WhiteFossa/ProjectFIH/README.md

# ProjectFIH
Digitally-controlled thermostat for heating outdoor hardware
