WhiteFossa/ProjectFIH/Hardware/Ideas/Idea 1.jpg

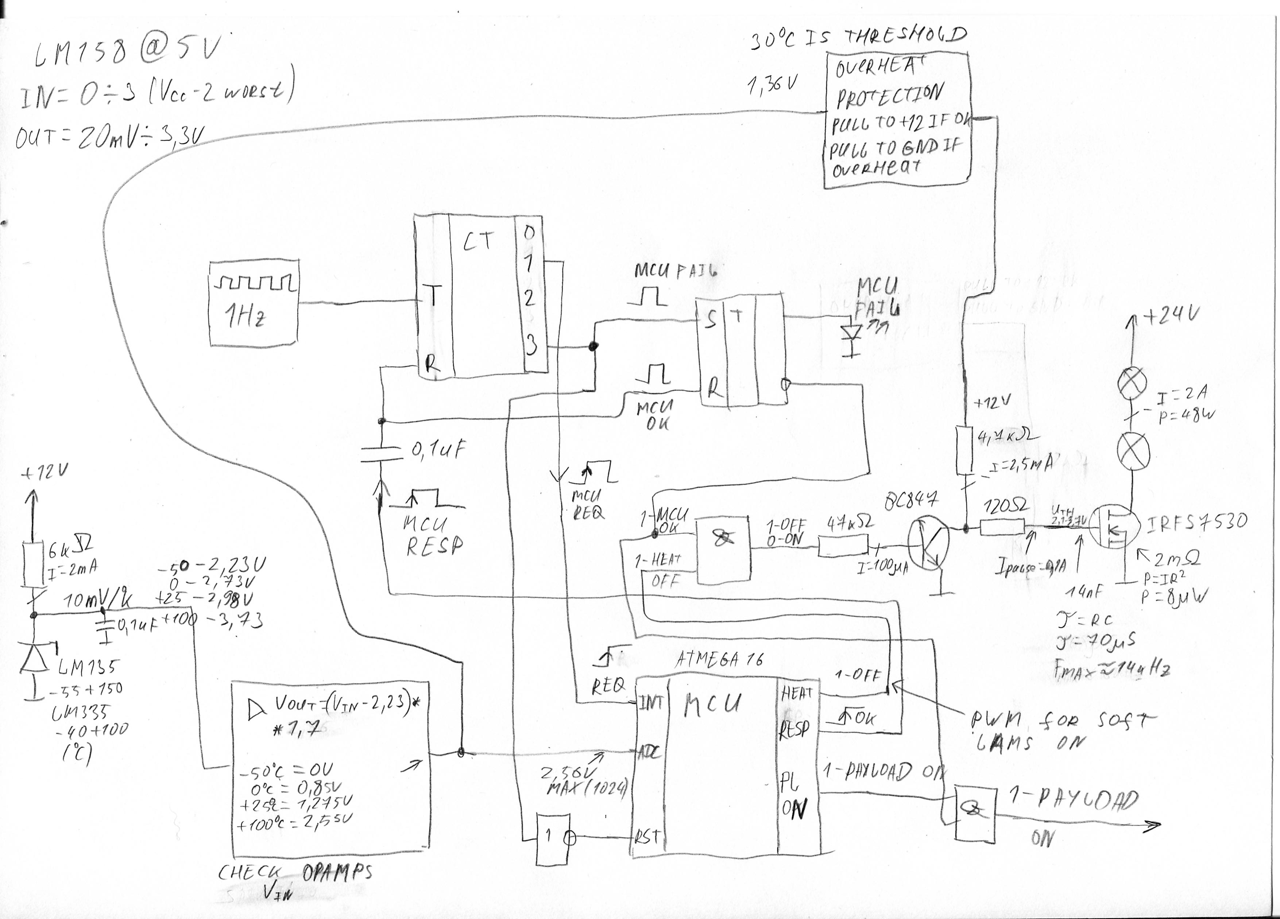
Hardware/Ideas/Idea 1.jpg
