WhiteFossa/ProjectFIH/Hardware/Ideas/Idea 2.jpg

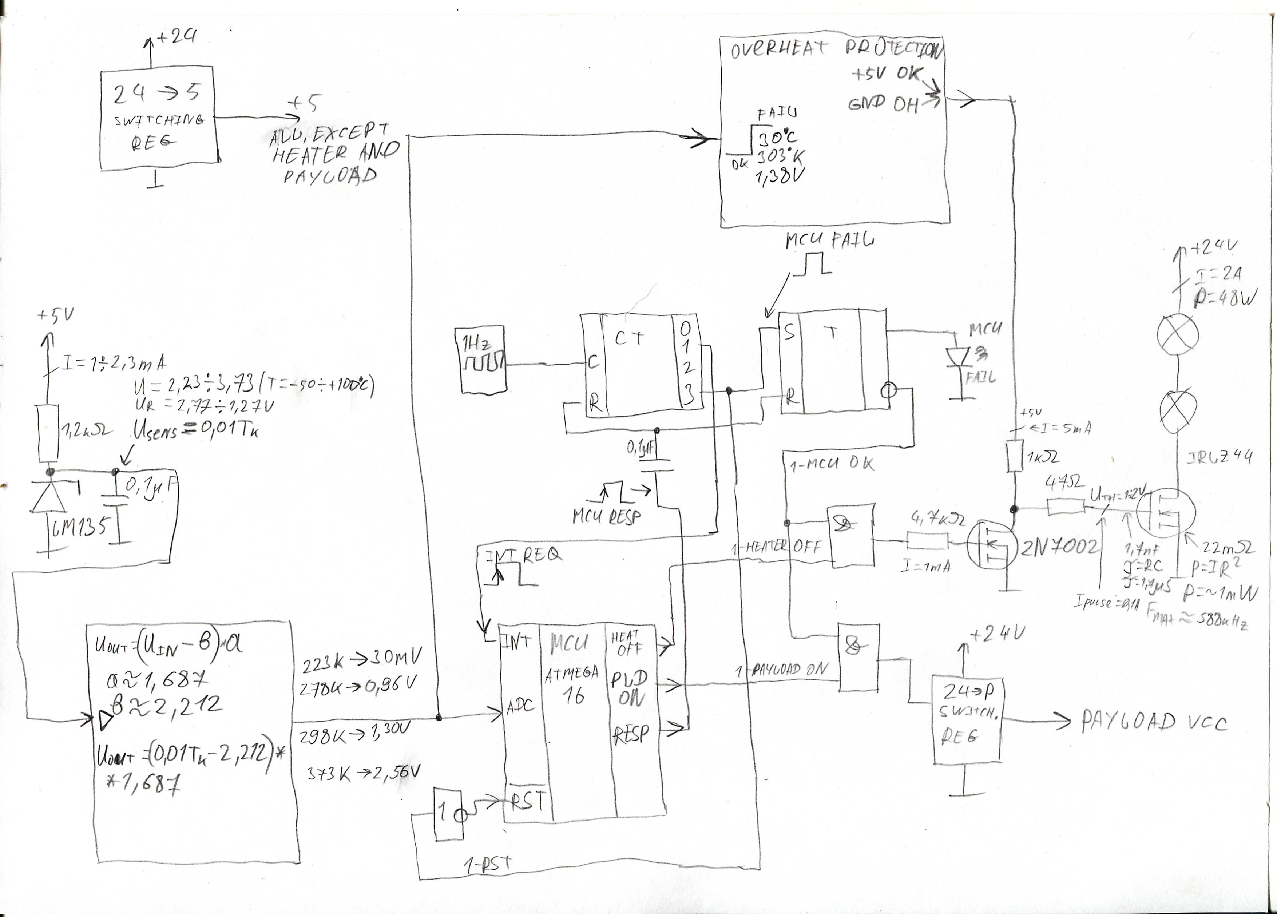
Hardware/Ideas/Idea 2.jpg
