WhiteFossa/ProjectFIH/Hardware/Complete/ProjectFIH/ProjectFIH.kicad_pcb

## KiCad design Hardware/Complete/ProjectFIH/ProjectFIH.kicad_pcb (2020-09-09)

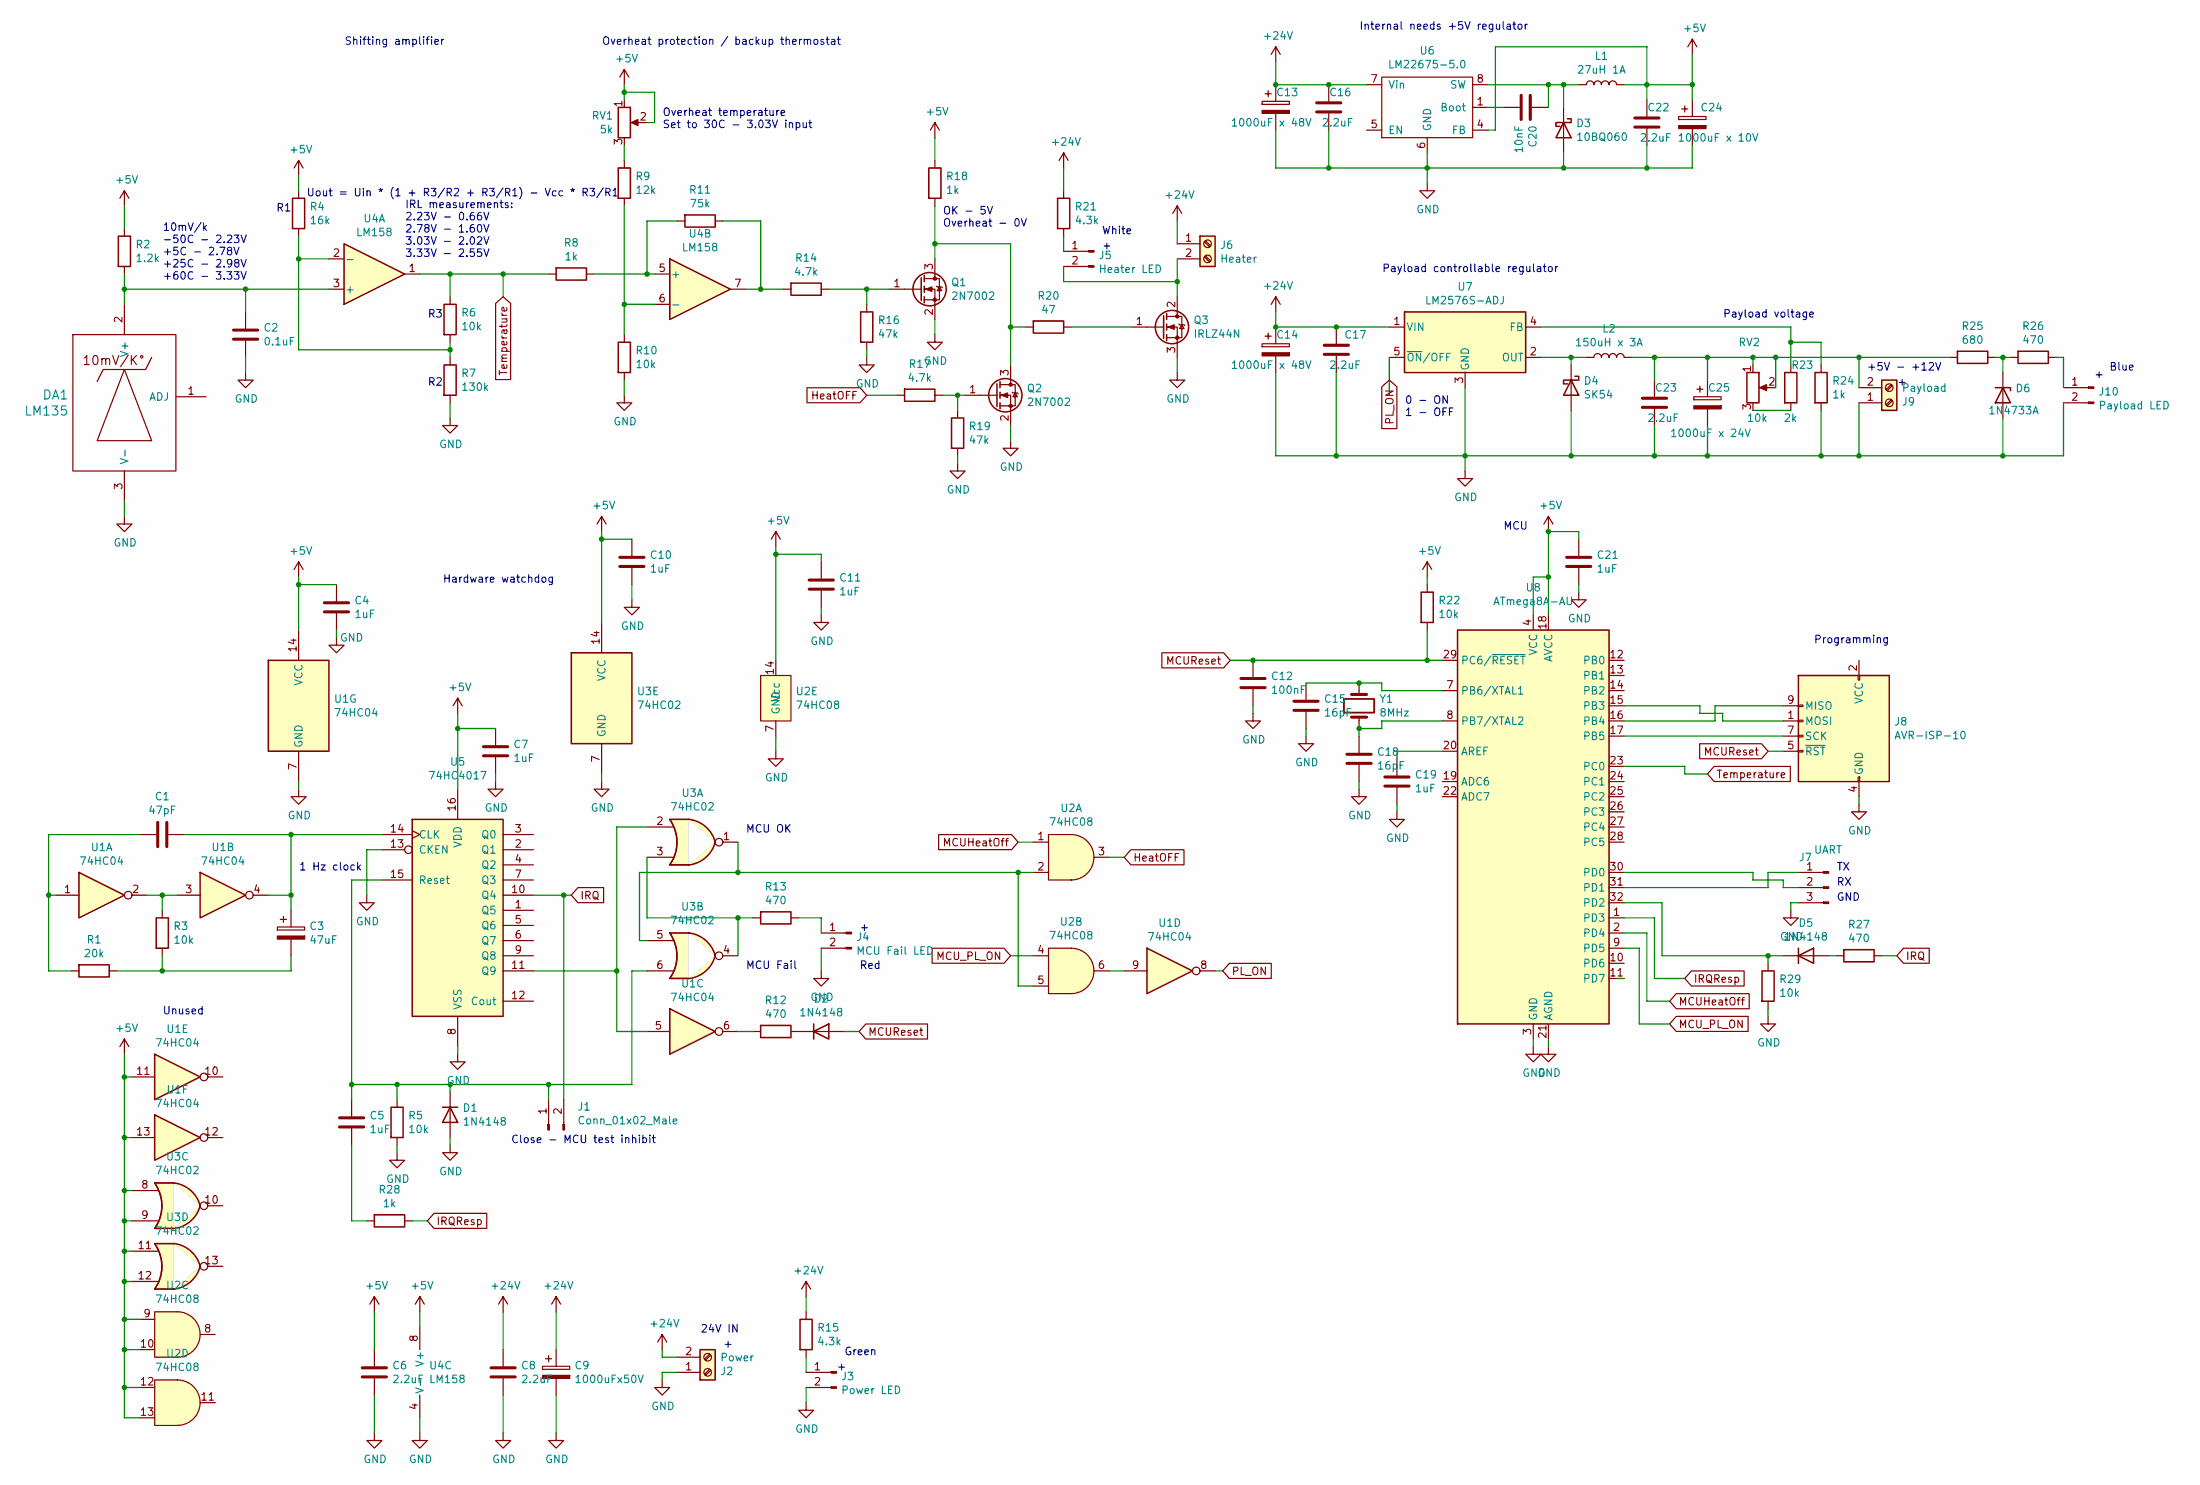
[picture p3: schematic ProjectFIH.sch, Project FIH]

Parts:
C1: 47pF; C_0805_2012Metric_Pad1.15x1.40mm_HandSolder
C2: 0.1uF; C_0805_2012Metric_Pad1.15x1.40mm_HandSolder
C3: 47uF; CP_Elec_4x5.7
C4, C5, C7, C10, C11, C19, C21: 1uF; C_0805_2012Metric_Pad1.15x1.40mm_HandSolder
C6, C8, C16, C17, C22, C23: 2.2uF; C_0805_2012Metric_Pad1.15x1.40mm_HandSolder
C9: 1000uFx50V; CP_Radial_D12.5mm_P5.00mm
C12: 100nF; C_0805_2012Metric_Pad1.15x1.40mm_HandSolder
C13, C14: 1000uF x 48V; CP_Radial_D12.5mm_P5.00mm
C15, C18: 16pF; C_0805_2012Metric_Pad1.15x1.40mm_HandSolder
C20: 10nF; C_0805_2012Metric_Pad1.15x1.40mm_HandSolder
C24: 1000uF x 10V; CP_Radial_D10.0mm_P5.00mm
C25: 1000uF x 24V; CP_Radial_D10.0mm_P5.00mm
D1, D2, D5: 1N4148; D_1210_3225Metric
D3: 10BQ060; D_SMB
D4: SK54; D_SMC
D6: 1N4733A; D_1210_3225Metric
DA1: LM135; TO-92
J1: Conn_01x02_Male; PinHeader_1x02_P2.54mm_Vertical
J2: Power; TerminalBlock_Altech_AK300-2_P5.00mm
J3: Power LED; PinHeader_1x02_P2.54mm_Vertical
J4: MCU Fail LED; PinHeader_1x02_P2.54mm_Vertical
J5: Heater LED; PinHeader_1x02_P2.54mm_Vertical
J6: Heater; TerminalBlock_Altech_AK300-2_P5.00mm
J7: UART; PinHeader_1x03_P2.54mm_Vertical
J8: AVR-ISP-10; IDC-Header_2x05_P2.54mm_Vertical
J9: Payload; TerminalBlock_Altech_AK300-2_P5.00mm
J10: Payload LED; PinHeader_1x02_P2.54mm_Vertical
L1: 27uH 1A; L_Radial_D10.0mm_P5.00mm_Fastron_07M
L2: 150uH x 3A; L_Radial_D16.8mm_P11.43mm_Vishay_IHB-1
Q1, Q2: 2N7002; SOT-23
Q3: IRLZ44N; TO-220-3_Horizontal_TabDown
R1: 20k; R_0805_2012Metric_Pad1.15x1.40mm_HandSolder
R2: 1.2k; R_0805_2012Metric_Pad1.15x1.40mm_HandSolder
R3, R5, R6, R10, R22, R29: 10k; R_0805_2012Metric_Pad1.15x1.40mm_HandSolder
R4: 16k; R_0805_2012Metric_Pad1.15x1.40mm_HandSolder
R7: 130k; R_0805_2012Metric_Pad1.15x1.40mm_HandSolder
R8, R18, R24, R28: 1k; R_0805_2012Metric_Pad1.15x1.40mm_HandSolder
R9: 12k; R_0805_2012Metric_Pad1.15x1.40mm_HandSolder
R11: 75k; R_0805_2012Metric_Pad1.15x1.40mm_HandSolder
R12, R13, R26, R27: 470; R_0805_2012Metric_Pad1.15x1.40mm_HandSolder
R14, R17: 4.7k; R_0805_2012Metric_Pad1.15x1.40mm_HandSolder
R15, R21: 4.3k; R_0805_2012Metric_Pad1.15x1.40mm_HandSolder
R16, R19: 47k; R_0805_2012Metric_Pad1.15x1.40mm_HandSolder
R20: 47; R_0805_2012Metric_Pad1.15x1.40mm_HandSolder
R23: 2k; R_0805_2012Metric_Pad1.15x1.40mm_HandSolder
R25: 680; R_0805_2012Metric_Pad1.15x1.40mm_HandSolder
RV1: 5k; Potentiometer_Bourns_3296W_Vertical
RV2: 10k; Potentiometer_Bourns_3296W_Vertical
U1: 74HC04; SOIC-14_3.9x8.7mm_P1.27mm
U2: 74HC08; SOIC-14_3.9x8.7mm_P1.27mm
U3: 74HC02; SOIC-14_3.9x8.7mm_P1.27mm
U4: LM158; SOIJ-8_5.3x5.3mm_P1.27mm
U5: 74HC4017; SOIC-16_4.55x10.3mm_P1.27mm
U6: LM22675-5.0; SOIC-8_3.9x4.9mm_P1.27mm
U7: LM2576S-ADJ; TO-263-5_TabPin3
U8: ATmega8A-AU; TQFP-32_7x7mm_P0.8mm
Y1: 8MHz; Crystal_HC49-4H_Vertical

Connections:
+5V: C4.1, C6.1, C7.1, C10.1, C11.1, C21.1, C22.1, C24.1, L1.2, R2.1, R4.1, R18.1, R22.1, RV1.1, RV1.2, U1.11, U1.13, U1.14 (VCC), U2.9, U2.10, U2.12, U2.13, U2.14 (Vcc), U3.8, U3.9, U3.11, U3.12, U3.14 (VCC), U4.8 (V+), U5.16 (VDD), U6.4 (FB), U8.4 (VCC), U8.6 (VCC), U8.18 (AVCC)
+24V: C8.1, C9.1, C13.1, C14.1, C16.1, C17.1, J2.2, J6.1, R15.1, R21.1, U6.7 (Vin), U7.1 (VIN)
GND: C2.2, C4.2, C6.2, C7.2, C8.2, C9.2, C10.2, C11.2, C12.2, C13.2, C14.2, C15.2, C16.2, C17.2, C18.2, C19.2, C21.2, C22.2, C23.2, C24.2, C25.2, D1.2 (A), D3.2 (A), D4.2 (A), D6.2 (A), DA1.3 (V-), J2.1, J3.2, J4.2, J7.3, J8.4 (GND), J8.6 (GND), J8.8 (GND), J8.10 (GND), J9.1, J10.2, Q1.2 (S), Q2.2 (S), Q3.3 (S), R5.2, R7.2, R10.2, R16.2, R19.2, R24.2, R29.2, U1.7 (GND), U2.7 (GND), U3.7 (GND), U4.4 (V-), U5.8 (VSS), U5.13 (CKEN), U6.6 (GND), U7.3 (GND), U8.3 (GND), U8.5 (GND), U8.21 (AGND)
HeatOFF: R17.2, U2.3
IRQ: J1.2, R27.1, U5.10 (Q4)
IRQResp: R28.1, U8.1 (PD3)
MCUHeatOff: U2.1, U8.2 (PD4)
MCUReset: C12.1, D2.2 (A), J8.5 (~RST), R22.2, U8.29 (PC6/~RESET)
MCU_PL_ON: U2.4, U8.9 (PD5)
unnamed: C1.1, C3.1, U1.4, U5.14 (CLK)
unnamed: C1.2, R1.2, U1.1
unnamed: C2.1, DA1.2 (V+), R2.2, U4.3 (+)
unnamed: C3.2, R1.1, R3.2
unnamed: C5.1, D1.1 (K), J1.1, R5.1, U3.6, U5.15 (Reset)
unnamed: C5.2, R28.2
unnamed: C15.1, U8.7 (PB6/XTAL1), Y1.2
unnamed: C18.1, U8.8 (PB7/XTAL2), Y1.1
unnamed: C19.1, U8.20 (AREF)
unnamed: C20.1, D3.1 (K), L1.1, U6.8 (SW)
unnamed: C20.2, U6.1 (Boot)
unnamed: C23.1, C25.1, J9.2, L2.2, R25.2, RV2.1, RV2.2
unnamed: D2.1 (K), R12.1
unnamed: D4.1 (K), L2.1, U7.2 (OUT)
unnamed: D5.1 (K), R29.1, U8.32 (PD2)
unnamed: D5.2 (A), R27.2
unnamed: D6.1 (K), R25.1, R26.2
unnamed: J3.1, R15.2
unnamed: J4.1, R13.1
unnamed: J5.1, R21.2
unnamed: J5.2, J6.2, Q3.2 (D)
unnamed: J7.1, U8.31 (PD1)
unnamed: J7.2, U8.30 (PD0)
unnamed: J8.1 (MOSI), U8.15 (PB3)
unnamed: J8.7 (SCK), U8.17 (PB5)
unnamed: J8.9 (MISO), U8.16 (PB4)
unnamed: J10.1, R26.1
unnamed: Q1.1 (G), R14.1, R16.1
unnamed: Q1.3 (D), Q2.3 (D), R18.2, R20.2
unnamed: Q2.1 (G), R17.1, R19.1
unnamed: Q3.1 (G), R20.1
unnamed: R3.1, U1.2, U1.3
unnamed: R4.2, R6.2, R7.1, U4.2 (-)
unnamed: R9.1, RV1.3
unnamed: R9.2, R10.1, U4.6 (-)
unnamed: R11.1, R14.2, U4.7
unnamed: R8.1, R11.2, U4.5 (+)
unnamed: R12.2, U1.6
unnamed: R13.2, U3.3, U3.4
unnamed: R23.1, R24.1, U7.4 (FB)
unnamed: R23.2, RV2.3
unnamed: U1.5, U3.2, U5.11 (Q9)
unnamed: U1.9, U2.6
unnamed: U2.2, U2.5, U3.1, U3.5
PL_ON: U1.8, U7.5 (~ON~/OFF)
Temperature: R6.1, R8.2, U4.1, U8.23 (PC0)

Notes on the sheet:
Uout = Uin * (1 + R3/R2 + R3/R1) - Vcc * R3/R1
10mV/k -50C - 2.23V +5C - 2.78V +25C - 2.98V +60C - 3.33V
IRL measurements: 2.23V - 0.66V 2.78V - 1.60V 3.03V - 2.02V 3.33V - 2.55V
OK - 5V Overheat - 0V
Internal needs +5V regulator
0 - ON 1 - OFF
Payload controllable regulator
+5V - +12V
1 Hz clock
MCU Fail
MCU OK
Close - MCU test inhibit
Overheat protection / backup thermostat
Shifting amplifier
Hardware watchdog
Unused
GND
Programming
MCU
24V IN
Red
Green
White
Blue
Payload voltage
Overheat temperature Set to 30C - 3.03V input

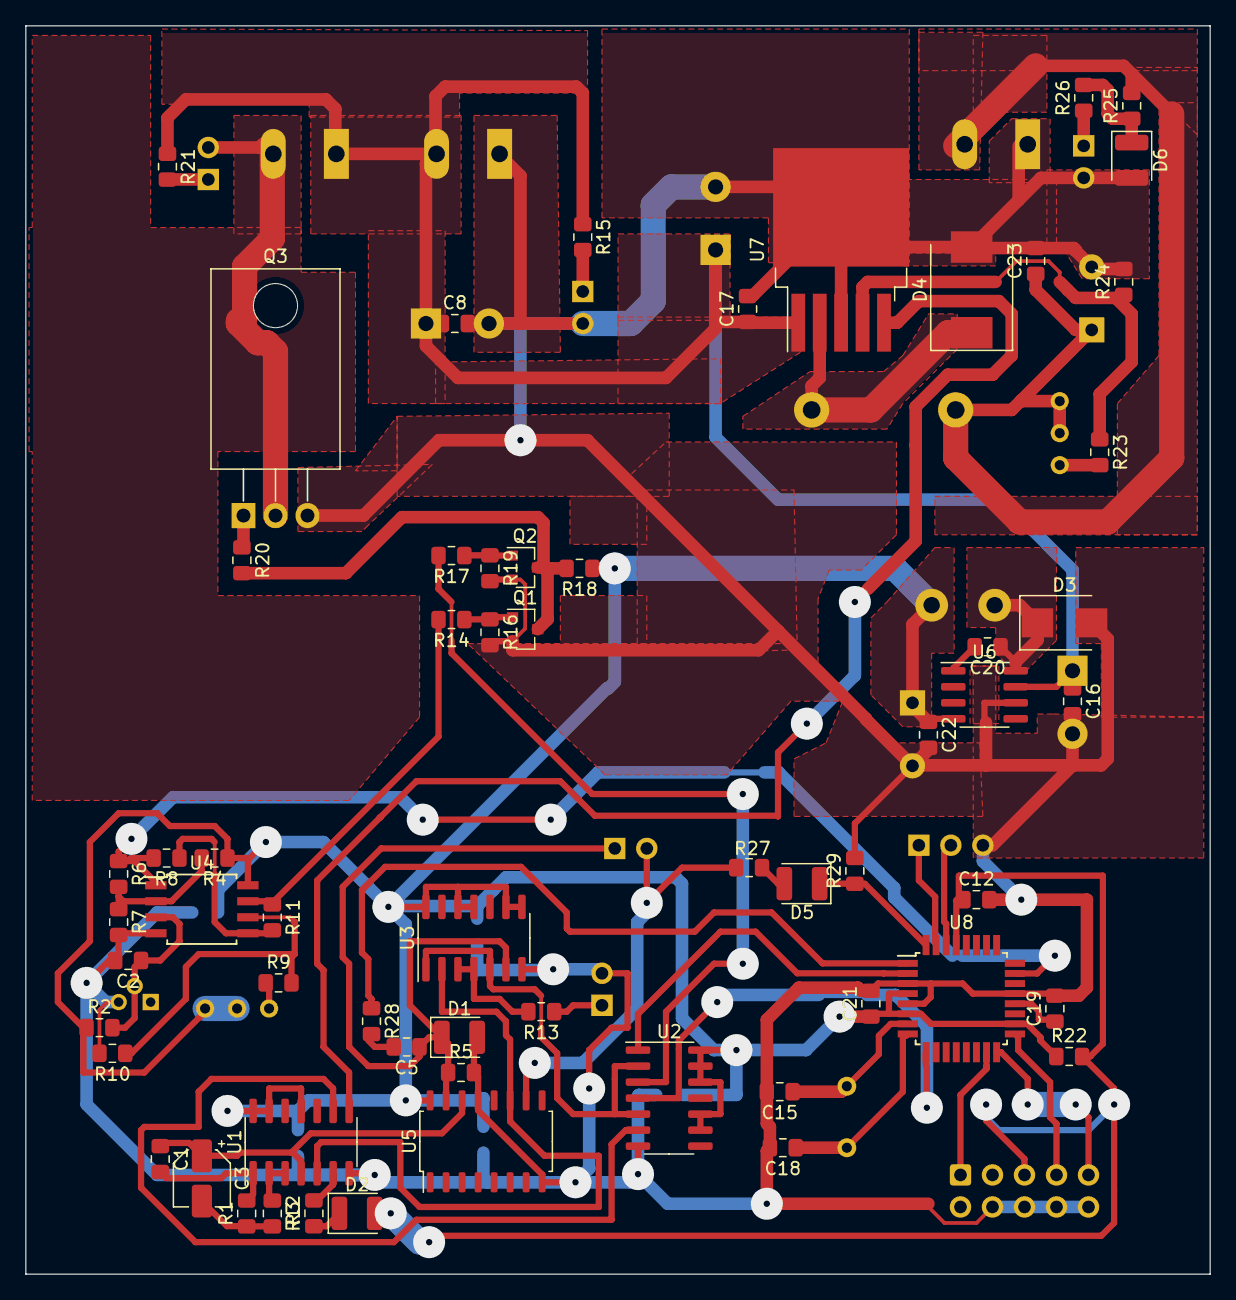
[picture p4: board ProjectFIH.kicad_pcb from above]

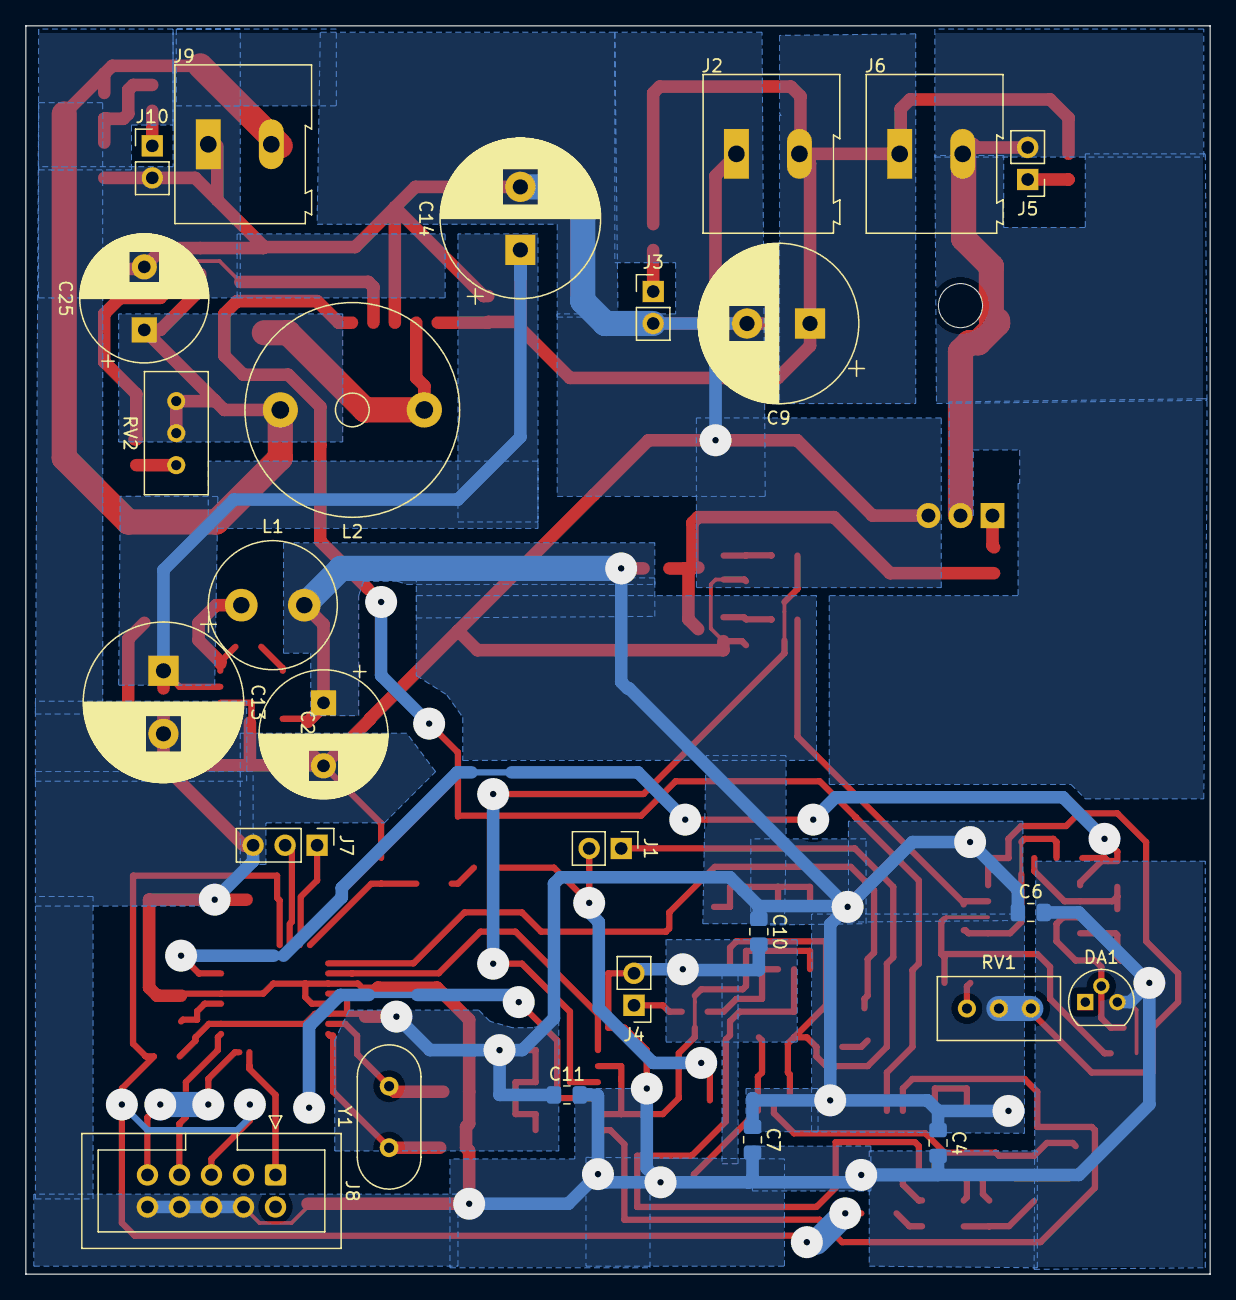
[picture p5: board ProjectFIH.kicad_pcb from below]

Board: 2 copper layers, 94.0 x 99.1 mm, 87 parts (26 on the bottom side), 55 nets.
