WhiteFossa/ProjectFIH/(commit log)

2020-07-01 Scaling amplifier simulation
    [ScalingAmplifier.sch]
2020-07-01 Started to draw device circuit diagram
    [ProjectFIH.kicad_pcb, ProjectFIH.sch]
2020-07-01 Found that real LM358 saturates at 0.6V output (low). So, recalculated and retested.
    [ProjectFIH.sch, ScalingAmplifier.sch]
2020-07-01 Comparer for overheat protection (simulation).
    [Overheat comparator.sch]
2020-07-03 Overheat protection comparator
    [Overheat comparator.sch, ProjectFIH.sch]
2020-07-04 Corrected hysterezis loop resistor.
    [ProjectFIH.sch]
2020-07-04 Output stage, heat control.
    [ProjectFIH.sch]
2020-07-11 Added 24 -> 5 regulator
    [ProjectFIH.sch]
2020-07-11 Added payload regulator
    [ProjectFIH.sch]
2020-07-14 Added hardware watchdog
    [ProjectFIH.sch]
2020-07-17 Fixed incorrect counter reset.
    Ready to add MCU and start PCB tracing
    [ProjectFIH.sch]
2020-07-19 Schematic seems to be completed
    [ProjectFIH.sch]
2020-07-21 Added LEDs
    [ProjectFIH.sch]
2020-07-23 Assigned some cases
    [ProjectFIH.sch]
2020-07-24 Cases assigned
    [ProjectFIH.sch]
2020-07-24 Fixed label and generated netlist
    [ProjectFIH.sch]
2020-07-24 Started to trace PCB
2020-07-25 Partially routed PCB
    [ProjectFIH.kicad_pcb, ProjectFIH.sch]
2020-07-27 More tracing
    [ProjectFIH.kicad_pcb, ProjectFIH.sch]
2020-08-01 Before coupling MCU with hardware watchdog
    [ProjectFIH.kicad_pcb]
2020-08-01 MCU coupled with hardware watchdog
    [ProjectFIH.kicad_pcb, ProjectFIH.sch]
2020-08-02 Need to connect units
    [ProjectFIH.kicad_pcb]
2020-08-02 Tracing done except widening and filling
    [ProjectFIH.kicad_pcb]
2020-08-03 Small corrections after laying IRL parts out
    [ProjectFIH.kicad_pcb, ProjectFIH.sch]
2020-08-04 Started tracks widening and filling
    [ProjectFIH.kicad_pcb]
2020-08-05 Flipped some (but not all needed) parts to other side
    [ProjectFIH.kicad_pcb, ProjectFIH.sch]
2020-08-05 Everything is on correct sides
    [ProjectFIH.kicad_pcb]
2020-08-05 Partially metallized empty spaces.
    [ProjectFIH.kicad_pcb]
2020-08-05 Most of metallization
    [ProjectFIH.kicad_pcb]
2020-08-06 Filled. Imperfect, but don't want to re-do.
    [ProjectFIH.kicad_pcb]
2020-08-06 Prepared phototemplates
    [ProjectFIH.kicad_pcb]
2020-08-07 Gerber files
    [ProjectFIH-B_Cu.gbr, ProjectFIH-Edge_Cuts.gbr, ProjectFIH-F_Cu.gbr, ProjectFIH-NPTH.drl, ProjectFIH-PTH.drl, ProjectFIH-job.gbrjob]
2020-08-15 Generated a BOM
2020-08-15 LM335 -> LM135
    [ProjectFIH.sch]
2020-08-16 Small PCB optimization
    [ProjectFIH.kicad_pcb]
2020-08-25 Small comments on schematic
    [ProjectFIH.sch]
2020-08-29 Small corrections
    [ProjectFIH.kicad_pcb, ProjectFIH.sch]
2020-08-29 Updated BOM
2020-08-30 Swapped outputs of U3
    [ProjectFIH.kicad_pcb, ProjectFIH.sch]
2020-09-08 Early firmware development.
    [ProjectFIH.kicad_pcb, ProjectFIH.sch]
2020-09-09 Important schematics and PCB fixes + some firmware development.
    [ProjectFIH.kicad_pcb, ProjectFIH.sch]
2020-09-13 Correct ADC averaging.
2020-09-13 Payload and heater temperature control
