WhiteFossa/ProjectFIH/(notices)

Notices in the files:
Hardware/Complete/ProjectFIH/ProjectFIH.sch:
AGPL
